maxpowel/auto-wire-stripper-cutter/readme_imgs/top3.jpg

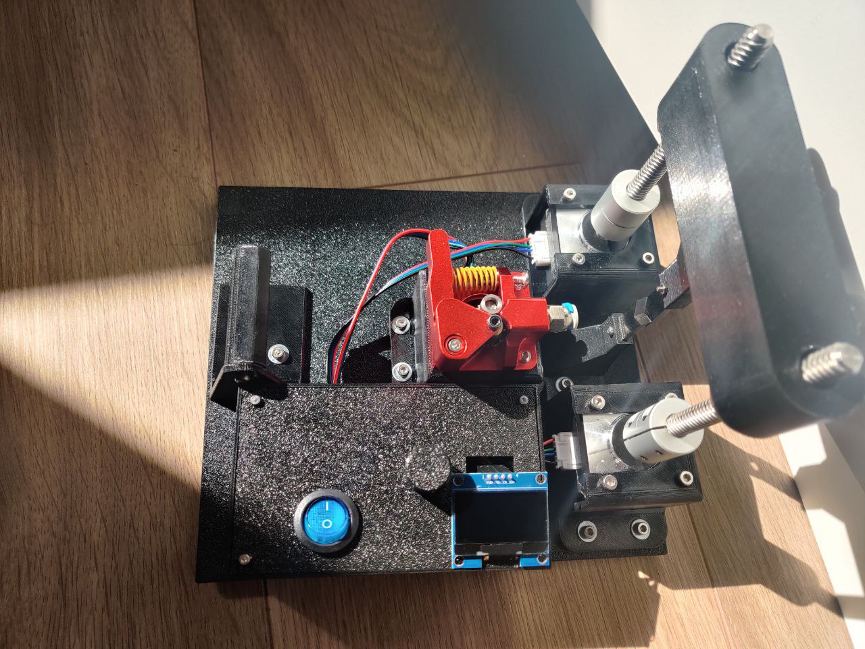
readme_imgs/top3.jpg
