maxpowel/auto-wire-stripper-cutter/readme_imgs/web-ui.png

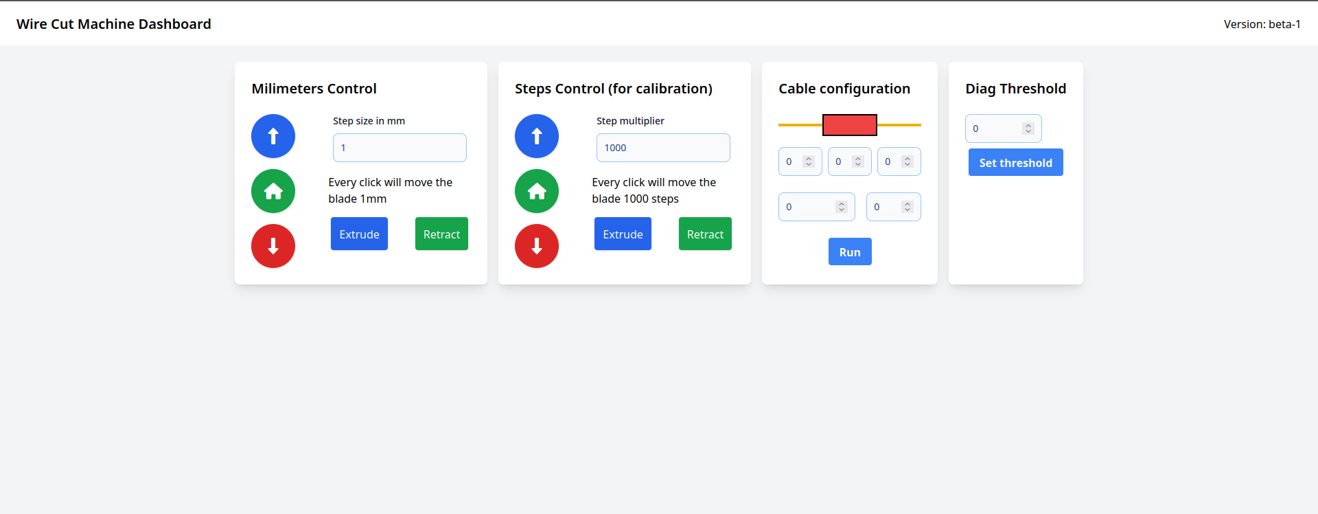
readme_imgs/web-ui.png
