maxpowel/auto-wire-stripper-cutter/3d_printing/wire_channel.3mf

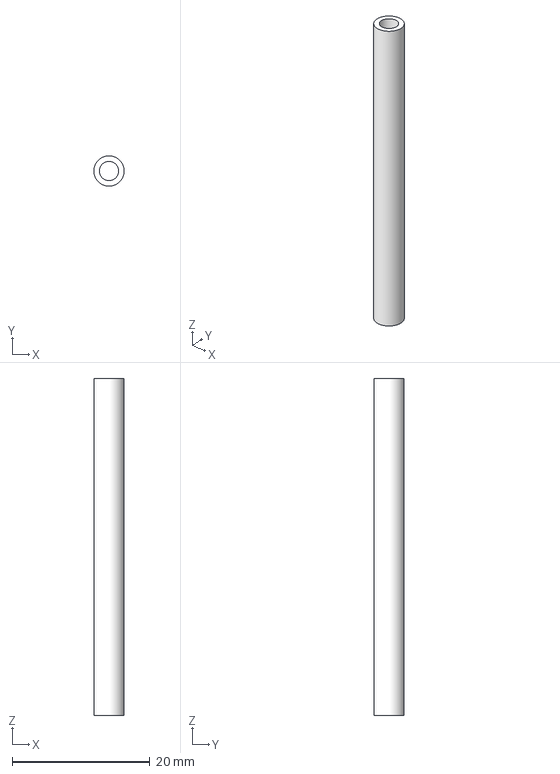
[picture p19: CAD file, 2022-03-04]
3d_printing/wire_channel.3mf
4.40 x 4.40 x 49.0 mm
