maxpowel/auto-wire-stripper-cutter/kicad-wire-cutter/TMC2209_SILENTSTEPSTICK/TMC2209_SILENTSTEPSTICK.step

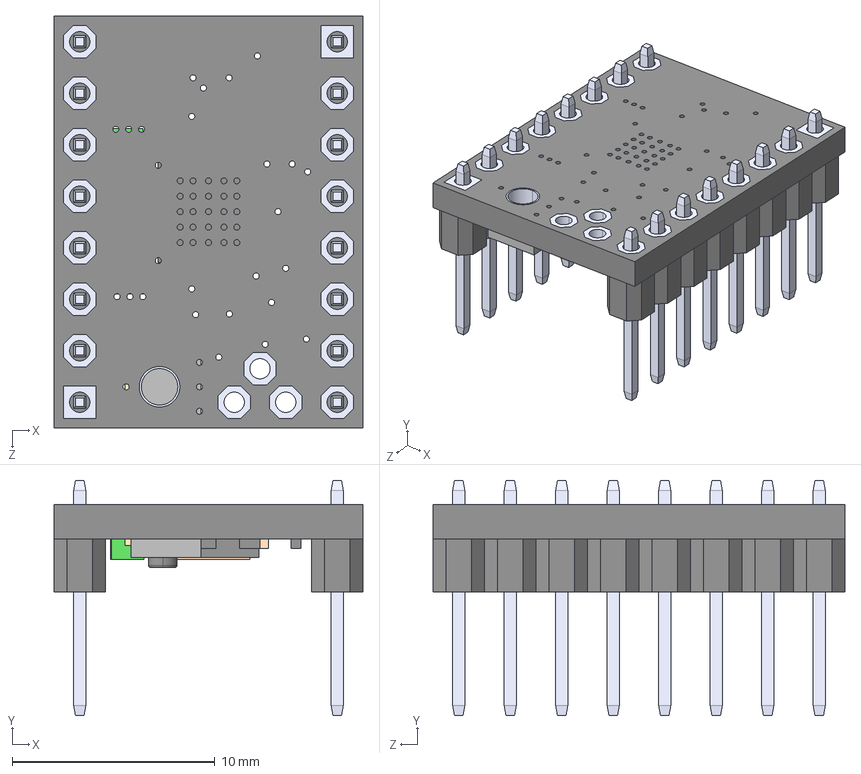
[picture p20: CAD file, 2024-10-01]
kicad-wire-cutter/TMC2209_SILENTSTEPSTICK/TMC2209_SILENTSTEPSTICK.step
15.2 x 11.6 x 20.3 mm
