maxpowel/auto-wire-stripper-cutter/3d_printing/spoolHolder_cylinder_cap.3mf

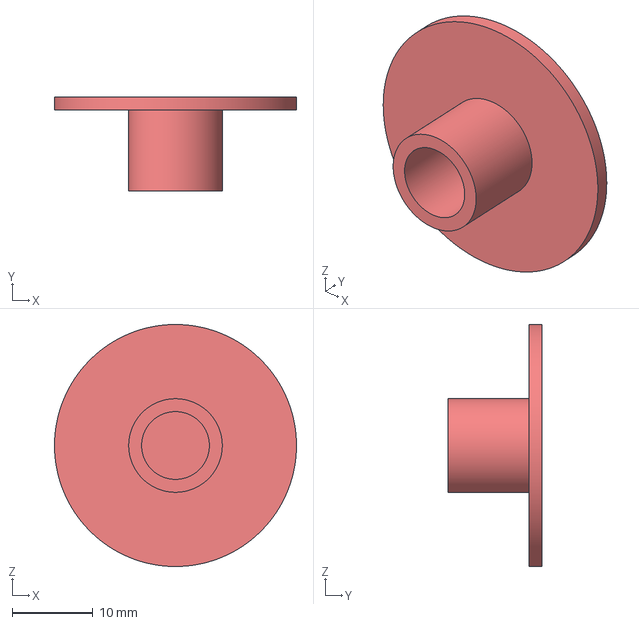
[picture p21: CAD file, 2022-03-04]
3d_printing/spoolHolder_cylinder_cap.3mf
30.0 x 11.6 x 30.0 mm
