maxpowel/auto-wire-stripper-cutter/3d_printing/linearMotion_motorsHousing.3mf

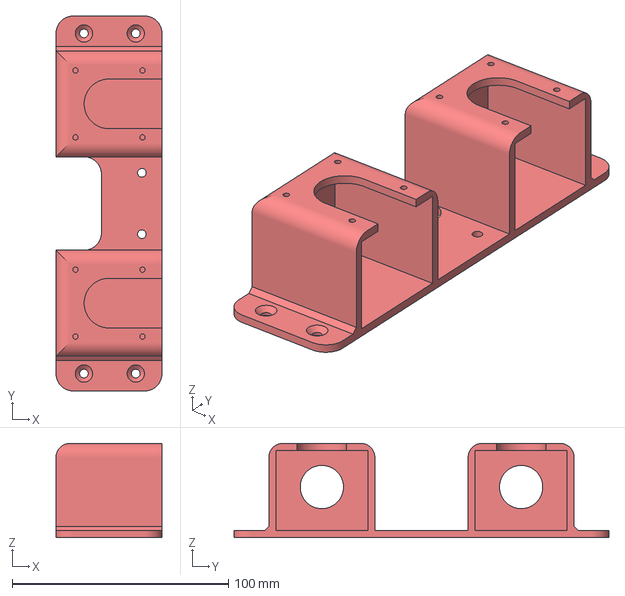
[picture p22: CAD file, 2022-03-04]
3d_printing/linearMotion_motorsHousing.3mf
49.0 x 173.6 x 43.6 mm
