maxpowel/auto-wire-stripper-cutter/3d_printing/extruderStepper_housing.3mf

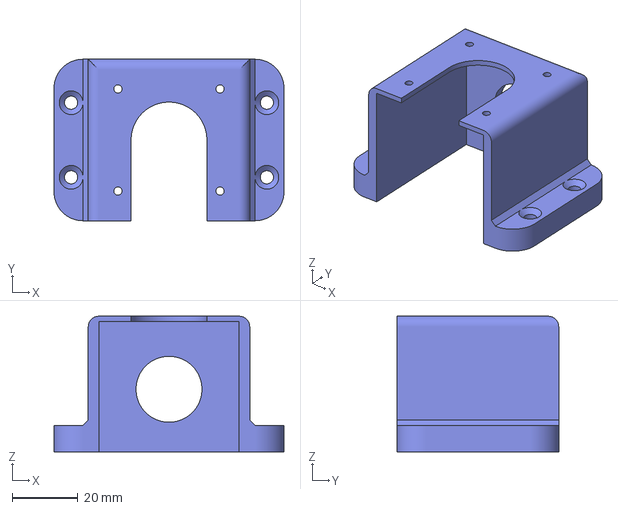
[picture p23: CAD file, 2022-03-04]
3d_printing/extruderStepper_housing.3mf
69.8 x 49.0 x 41.2 mm
