maxpowel/auto-wire-stripper-cutter/3d_printing/bottomBlade_housing.3mf

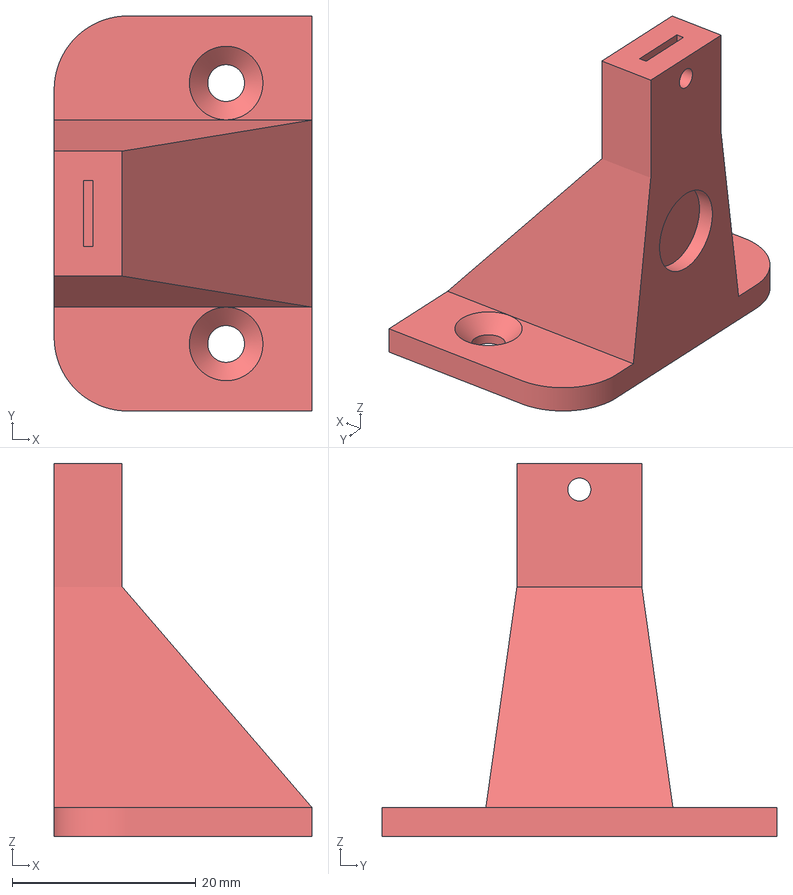
[picture p24: CAD file, 2022-03-04]
3d_printing/bottomBlade_housing.3mf
28.0 x 43.0 x 40.6 mm
