maxpowel/auto-wire-stripper-cutter/3d_printing/spoolHolder_cylinder.3mf

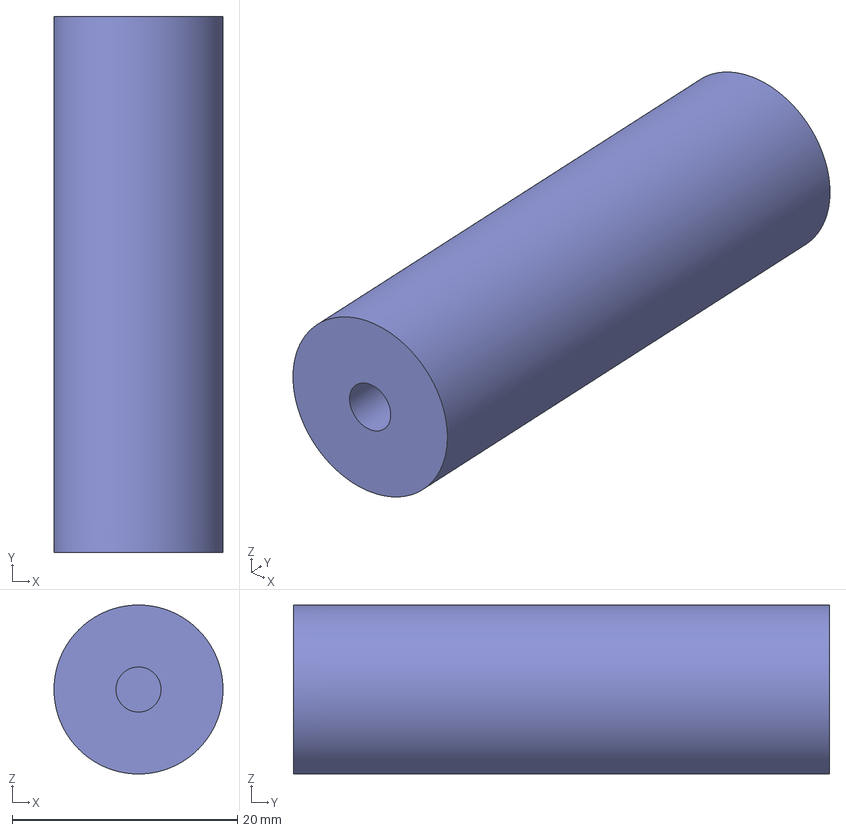
[picture p25: CAD file, 2022-03-04]
3d_printing/spoolHolder_cylinder.3mf
15.0 x 47.6 x 15.0 mm
