maxpowel/auto-wire-stripper-cutter/3d_printing/wiring_housing.3mf

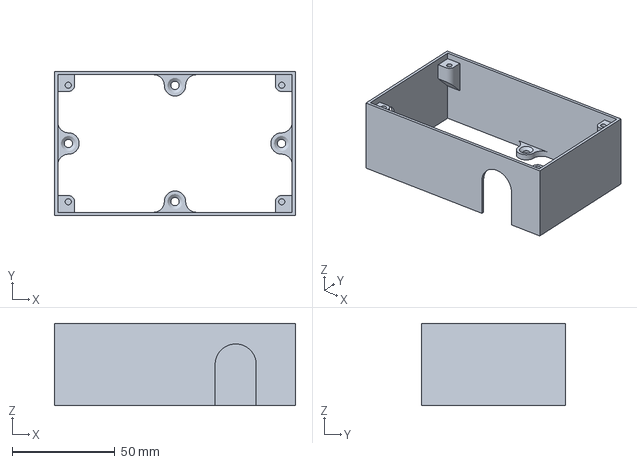
[picture p26: CAD file, 2022-03-04]
3d_printing/wiring_housing.3mf
117.4 x 70.2 x 40.0 mm
