maxpowel/auto-wire-stripper-cutter/3d_printing/linearMotion_attachment.3mf

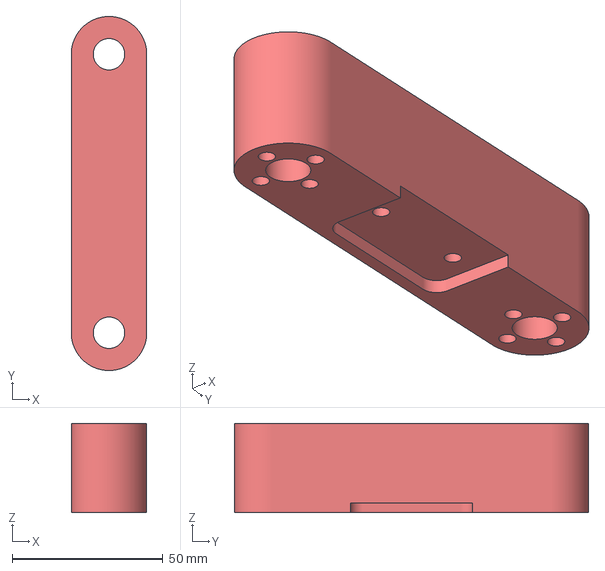
[picture p27: CAD file, 2022-03-04]
3d_printing/linearMotion_attachment.3mf
25.0 x 117.2 x 29.6 mm
