maxpowel/auto-wire-stripper-cutter/3d_printing/wiring_housing_lid.3mf

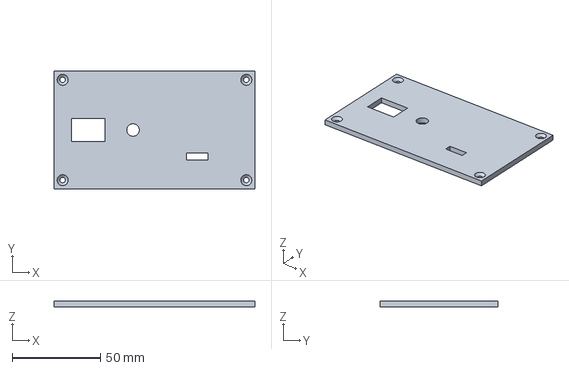
[picture p28: CAD file, 2022-03-04]
3d_printing/wiring_housing_lid.3mf
113.8 x 66.6 x 3.20 mm
