maxpowel/auto-wire-stripper-cutter/3d_printing/container.3mf

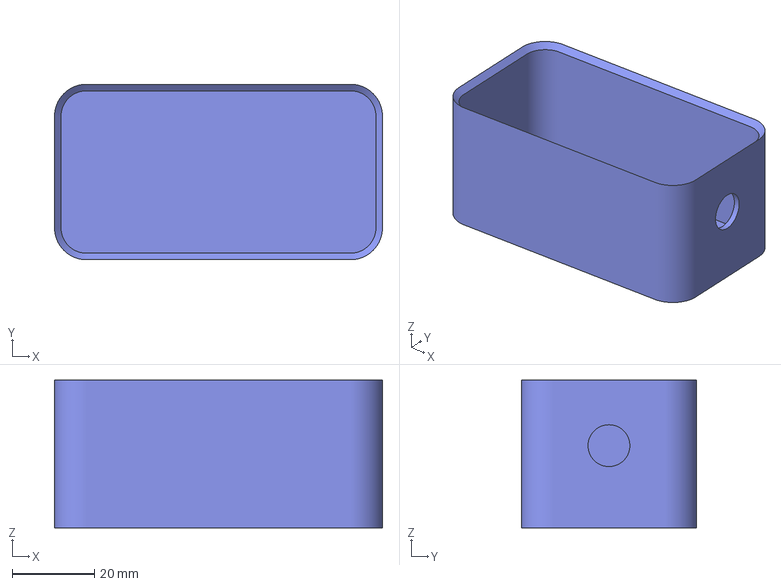
[picture p29: CAD file, 2022-03-04]
3d_printing/container.3mf
80.0 x 42.8 x 36.0 mm
