maxpowel/auto-wire-stripper-cutter/3d_printing/spoolHolder_base.3mf

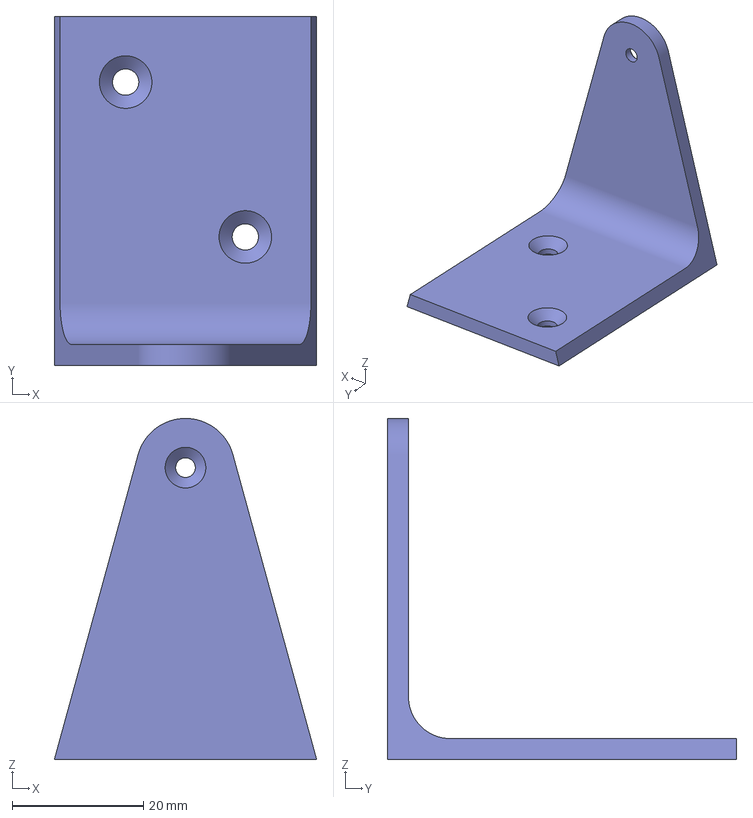
[picture p30: CAD file, 2022-03-04]
3d_printing/spoolHolder_base.3mf
40.0 x 53.2 x 52.0 mm
