maxpowel/auto-wire-stripper-cutter/3d_printing/topBlade_housing.3mf

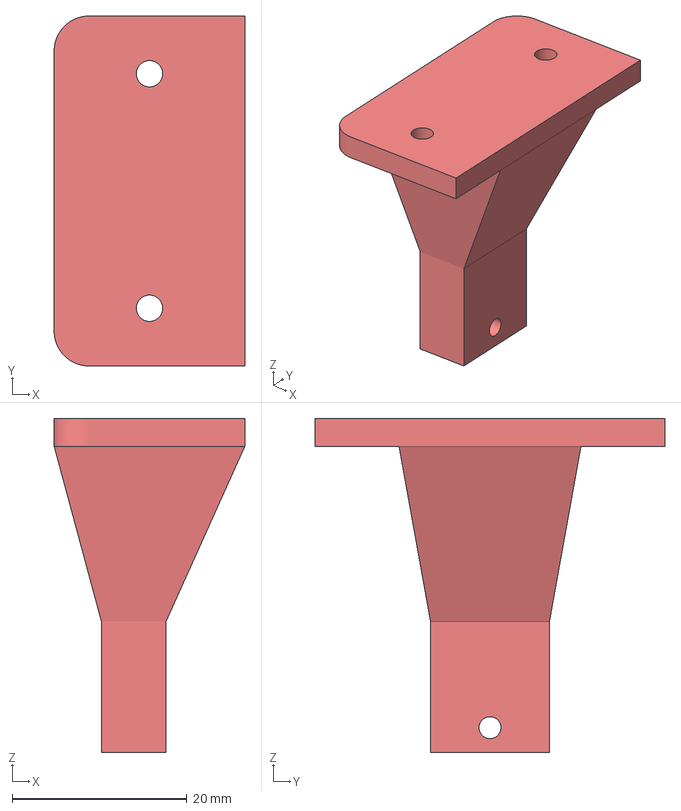
[picture p31: CAD file, 2022-03-04]
3d_printing/topBlade_housing.3mf
21.8 x 40.0 x 38.2 mm
