maxpowel/auto-wire-stripper-cutter/(list of files, cad)

Other CAD files:
3d_printing/stl/bottomBlade_housing.stl
3d_printing/stl/container.stl
3d_printing/stl/extruderStepper_housing.stl
3d_printing/stl/spoolHolder_base.stl
3d_printing/stl/spoolHolder_cylinder.stl
3d_printing/stl/spoolHolder_cylinder_cap.stl
3d_printing/stl/topBlade_housing.stl
3d_printing/stl/wiring_housing.stl
3d_printing/stl/wiring_housing_lid.stl
