maxpowel/auto-wire-stripper-cutter/3d_printing/README.md

# 3D printing

All the 3D printed parts used in this project.

- `/stl`, same models but in stl format.
- `assembly_model.step`, the full design in `.step` format.
