maxpowel/auto-wire-stripper-cutter/readme_imgs/testing_board.jpg

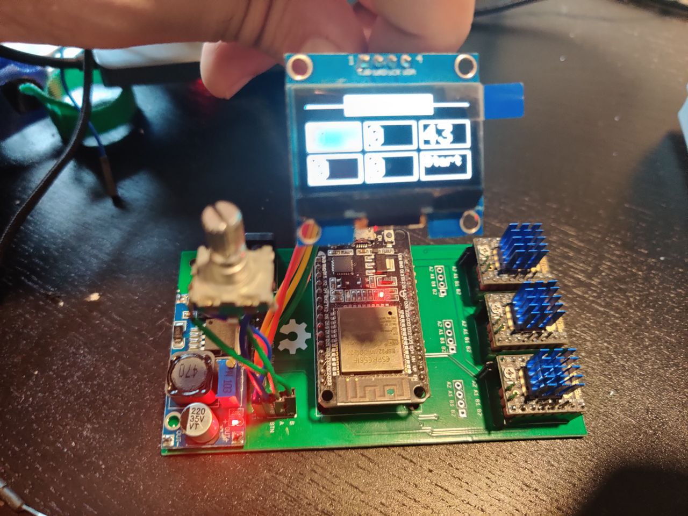
readme_imgs/testing_board.jpg
