maxpowel/auto-wire-stripper-cutter/kicad-wire-cutter/wire-cutter.kicad_pcb

## KiCad design kicad-wire-cutter/wire-cutter.kicad_pcb (2024-10-01)

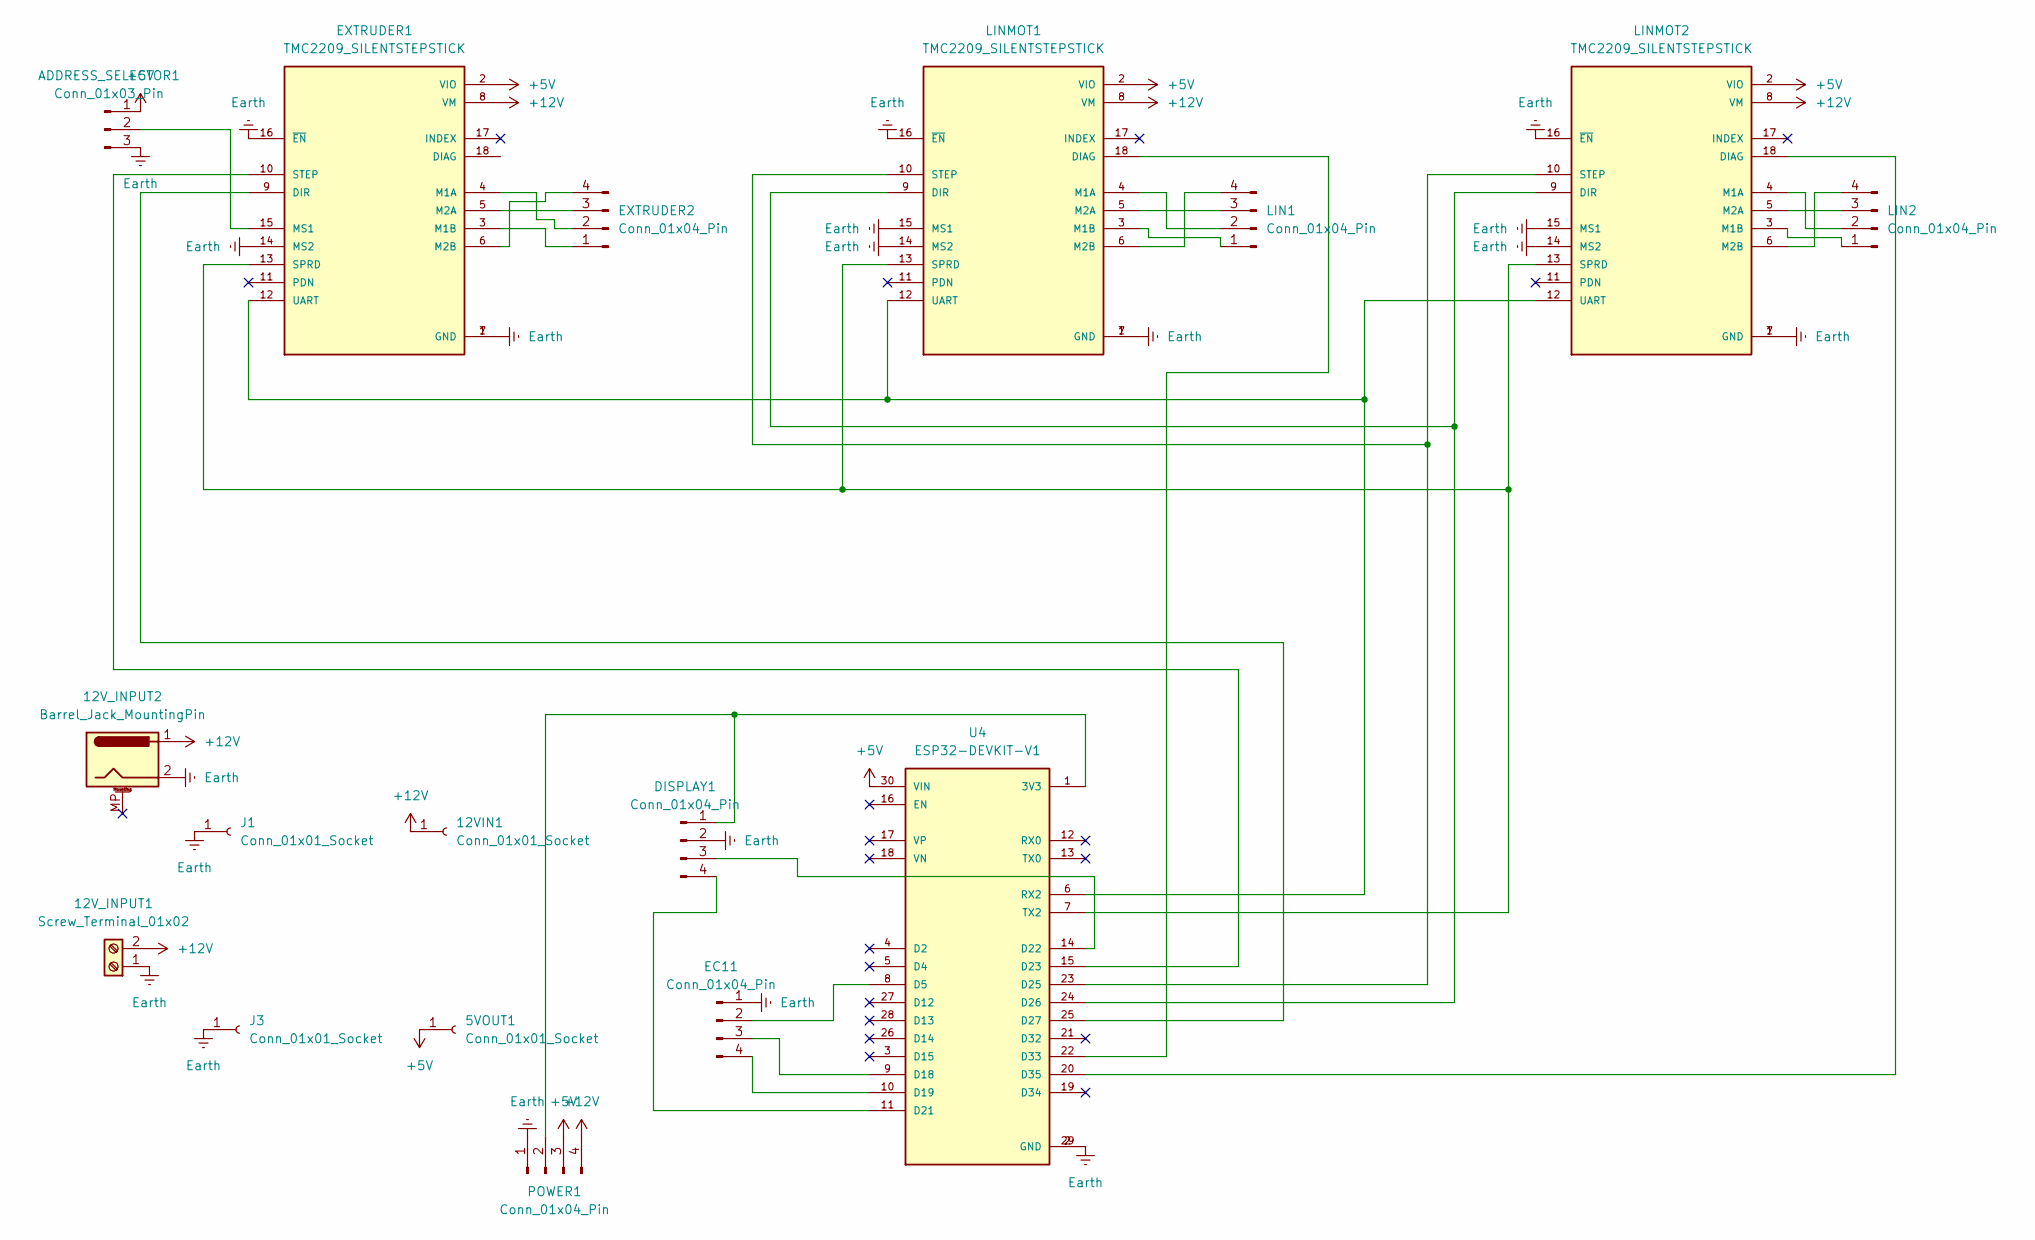
[picture p33: schematic wire-cutter.kicad_sch]

Parts:
5VOUT1, 12VIN1: Conn_01x01_Socket; PinHeader_1x01_P2.54mm_Vertical
12V_INPUT1: Screw_Terminal_01x02; TerminalBlock_bornier-2_P5.08mm
12V_INPUT2: Barrel_Jack_MountingPin; BarrelJack_Horizontal
ADDRESS_SELECTOR1: Conn_01x03_Pin; PinHeader_1x03_P2.54mm_Vertical
DISPLAY1: Conn_01x04_Pin; PinHeader_1x04_P2.54mm_Vertical
EC11: Conn_01x04_Pin; PinHeader_1x04_P2.54mm_Vertical
EXTRUDER1: TMC2209_SILENTSTEPSTICK; MODULE_TMC2209_SILENTSTEPSTICK; PARTREV 1.20
EXTRUDER2: Conn_01x04_Pin; PinSocket_1x04_P2.54mm_Vertical
J1, J3: Conn_01x01_Socket; PinHeader_1x01_P2.54mm_Vertical
LIN1, LIN2: Conn_01x04_Pin; PinSocket_1x04_P2.54mm_Vertical
LINMOT1, LINMOT2: TMC2209_SILENTSTEPSTICK; MODULE_TMC2209_SILENTSTEPSTICK; PARTREV 1.20
POWER1: Conn_01x04_Pin; PinHeader_1x04_P2.54mm_Vertical
U4: ESP32-DEVKIT-V1; MODULE_ESP32_DEVKIT_V1; PARTREV N/A

Connections:
+5V: 5VOUT1.1, ADDRESS_SELECTOR1.1, EXTRUDER1.2 (VIO), LINMOT1.2 (VIO), LINMOT2.2 (VIO), POWER1.3, U4.30 (VIN)
+12V: 12VIN1.1, 12V_INPUT1.2, 12V_INPUT2.1, EXTRUDER1.8 (VM), LINMOT1.8 (VM), LINMOT2.8 (VM), POWER1.4
Earth: 12V_INPUT1.1, 12V_INPUT2.2, ADDRESS_SELECTOR1.3, DISPLAY1.2, EC11.1, EXTRUDER1.1 (GND), EXTRUDER1.7 (GND), EXTRUDER1.14 (MS2), EXTRUDER1.16 (~EN), J1.1, J3.1, LINMOT1.1 (GND), LINMOT1.7 (GND), LINMOT1.14 (MS2), LINMOT1.15 (MS1), LINMOT1.16 (~EN), LINMOT2.1 (GND), LINMOT2.7 (GND), LINMOT2.14 (MS2), LINMOT2.15 (MS1), LINMOT2.16 (~EN), POWER1.1, U4.2 (GND), U4.29 (GND)
unnamed: ADDRESS_SELECTOR1.2, EXTRUDER1.15 (MS1)
unnamed: DISPLAY1.1, POWER1.2, U4.1 (3V3)
unnamed: DISPLAY1.3, U4.14 (D22)
unnamed: DISPLAY1.4, U4.11 (D21)
unnamed: EC11.2, U4.8 (D5)
unnamed: EC11.3, U4.9 (D18)
unnamed: EC11.4, U4.10 (D19)
unnamed: EXTRUDER1.9 (DIR), U4.25 (D27)
unnamed: EXTRUDER1.4 (M1A), EXTRUDER2.2
unnamed: EXTRUDER1.3 (M1B), EXTRUDER2.1
unnamed: EXTRUDER1.5 (M2A), EXTRUDER2.3
unnamed: EXTRUDER1.6 (M2B), EXTRUDER2.4
unnamed: EXTRUDER1.13 (SPRD), LINMOT1.13 (SPRD), LINMOT2.13 (SPRD), U4.7 (TX2)
unnamed: EXTRUDER1.10 (STEP), U4.15 (D23)
unnamed: EXTRUDER1.12 (UART), LINMOT1.12 (UART), LINMOT2.12 (UART), U4.6 (RX2)
unnamed: LIN1.1, LINMOT1.3 (M1B)
unnamed: LIN1.2, LINMOT1.4 (M1A)
unnamed: LIN1.3, LINMOT1.5 (M2A)
unnamed: LIN1.4, LINMOT1.6 (M2B)
unnamed: LIN2.1, LINMOT2.3 (M1B)
unnamed: LIN2.2, LINMOT2.4 (M1A)
unnamed: LIN2.3, LINMOT2.5 (M2A)
unnamed: LIN2.4, LINMOT2.6 (M2B)
unnamed: LINMOT1.18 (DIAG), U4.22 (D33)
unnamed: LINMOT1.9 (DIR), LINMOT2.9 (DIR), U4.24 (D26)
unnamed: LINMOT1.10 (STEP), LINMOT2.10 (STEP), U4.23 (D25)
unnamed: LINMOT2.18 (DIAG), U4.20 (D35)

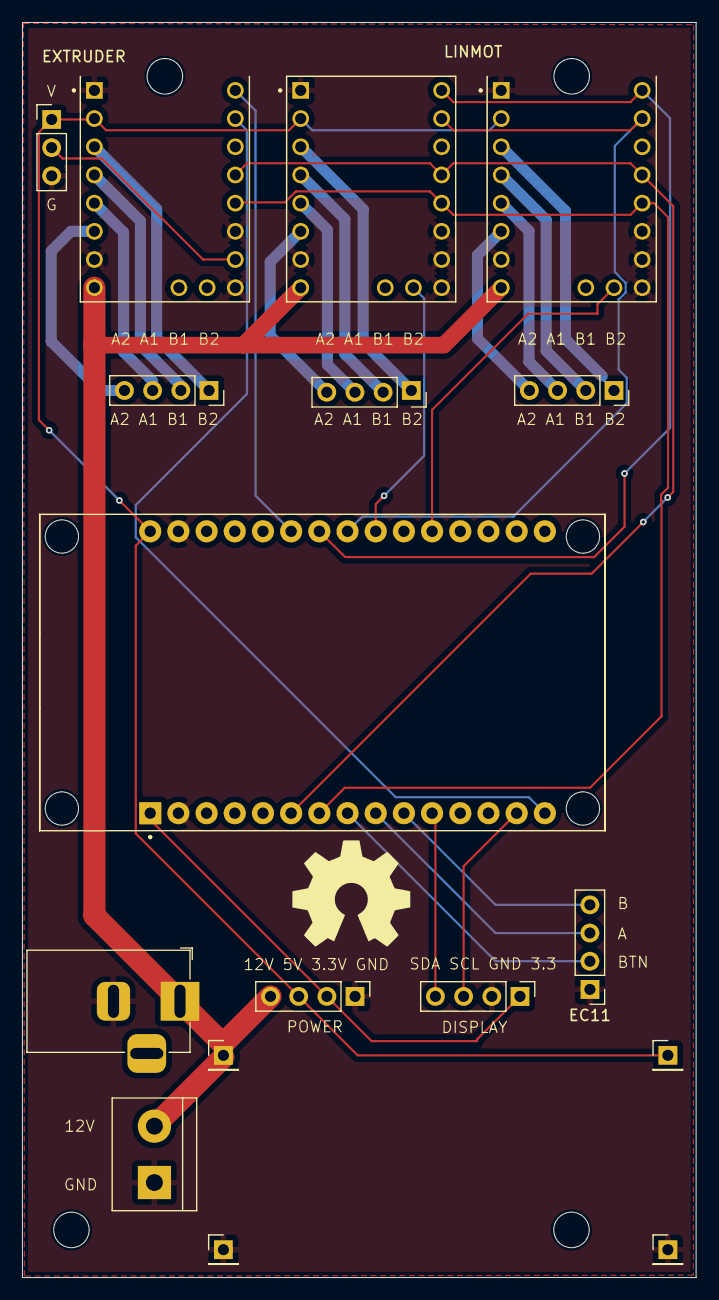
[picture p34: board wire-cutter.kicad_pcb from above]

Board: 2 copper layers, 60.7 x 113.1 mm, 17 parts (0 on the bottom side), 30 nets.
