maxpowel/auto-wire-stripper-cutter/(commit log)

2022-03-04 Update readme, add Arduino sketch.
2022-03-04 Add 3D models.
    [bottomBlade_housing.3mf, container.3mf, extruderStepper_housing.3mf, linearMotion_attachment.3mf, linearMotion_motorsHousing.3mf, spoolHolder_base.3mf, spoolHolder_cylinder.3mf, spoolHolder_cylinder_cap.3mf]
2022-05-23 Add assembly layout.
2022-07-25 Add oled display i2c address note
2022-08-01 Add note for ESP32 boot button on upload
2022-09-26 Add board size to assembly layout pdf
2022-09-26 Add gitignore and auto format arduino sketch
2022-09-26 Fix encoder interrupt issue
2022-11-24 Add stl 3d models.
    [bottomBlade_housing.stl, container.stl, extruderStepper_housing.stl, spoolHolder_base.stl, spoolHolder_cylinder.stl, spoolHolder_cylinder_cap.stl, topBlade_housing.stl, wiring_housing.stl]
2023-04-16 Add assembly model design file.
2024-09-27 Added initial version
    [auto-wire-stripper-cutter-bom_US.xlsx, base.scad]
2024-10-01 Added PCB files and improved README
    [TMC2209_SILENTSTEPSTICK.step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]
2024-10-17 Added PCB images
2024-10-22 Finished full cut process
    [wire-cutter.kicad_pcb, wire-cutter.kicad_sch]
